MF-Ahmed/30-channel-remote-input-status-monitoring-system/(list of files, cad)

Other CAD files:
firmware/backup_29-03-2019/RIMS_4_BYTE_RECIEVER.X/dist/default/production/RIMS_4_BYTE_RECIEVER.X.production.obj
firmware/backup_29-03-2019/RIMS_4BYTE.X/dist/default/production/RIMS_4BYTE.X.production.obj
firmware/RIMS_4_BYTE_RECIEVER.X/dist/default/production/RIMS_4_BYTE_RECIEVER.X.production.obj
firmware/RIMS_4_BYTE_RECIEVER.X/l.obj
firmware/RIMS_4BYTE.X/l.obj
