MF-Ahmed/30-channel-remote-input-status-monitoring-system/Manual/flow chart01.pdf

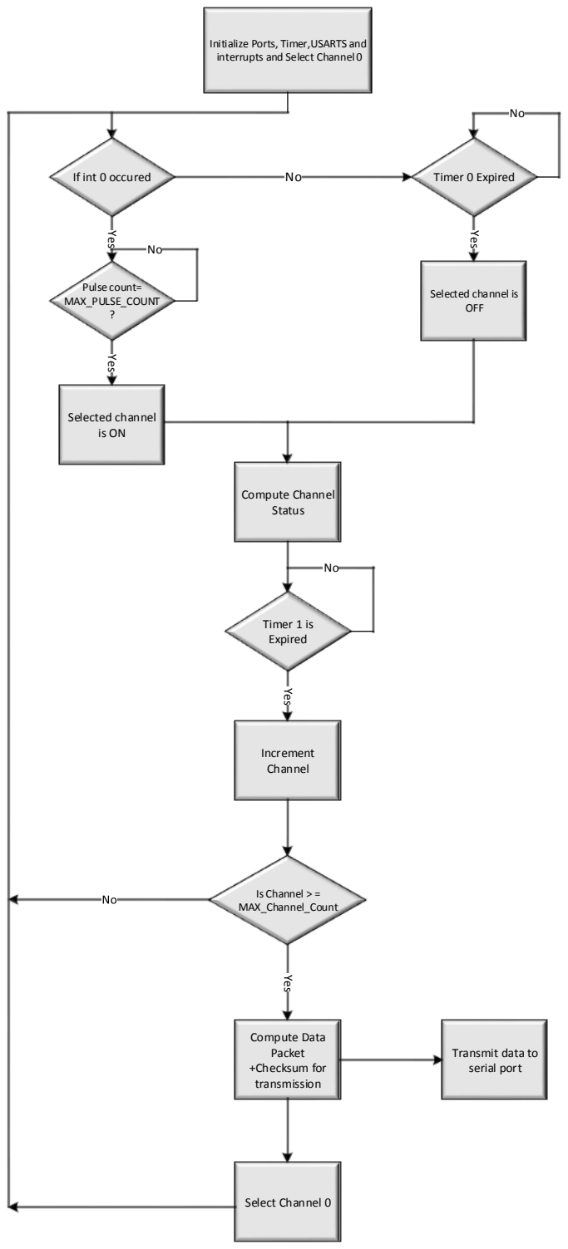
[picture p8: page 1]

If int 0 occured

Initialize Ports, Timer,USARTS and interrupts and Select Channel 0

Pulse count=
MAX_PULSE_COUNT
?

Selected channel
is ON

Timer 0 Expired

Selected channel is
OFF

Compute Channel
Status

Timer 1 is
Expired

Compute Data
Packet
+Checksum for
transmission

Is Channel > =
MAX_Channel_Count

Increment
Channel

Transmit data to
serial port

Select Channel 0

No

Yes

Yes

Yes Yes

Yes

No

No

No
