MF-Ahmed/30-channel-remote-input-status-monitoring-system/Manual/Master.png

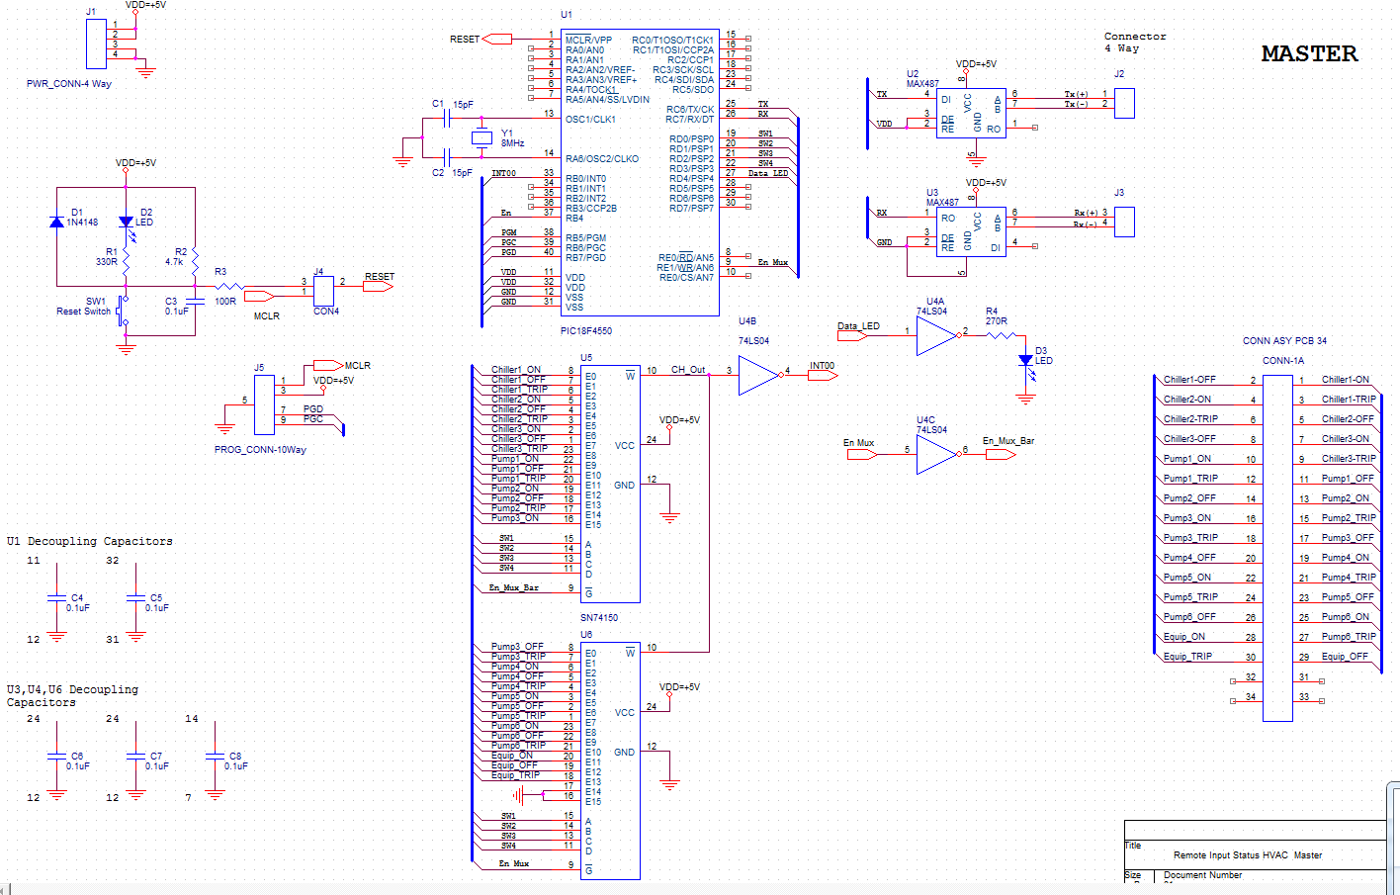
Manual/Master.png
