MF-Ahmed/30-channel-remote-input-status-monitoring-system/Manual/opto-1.png

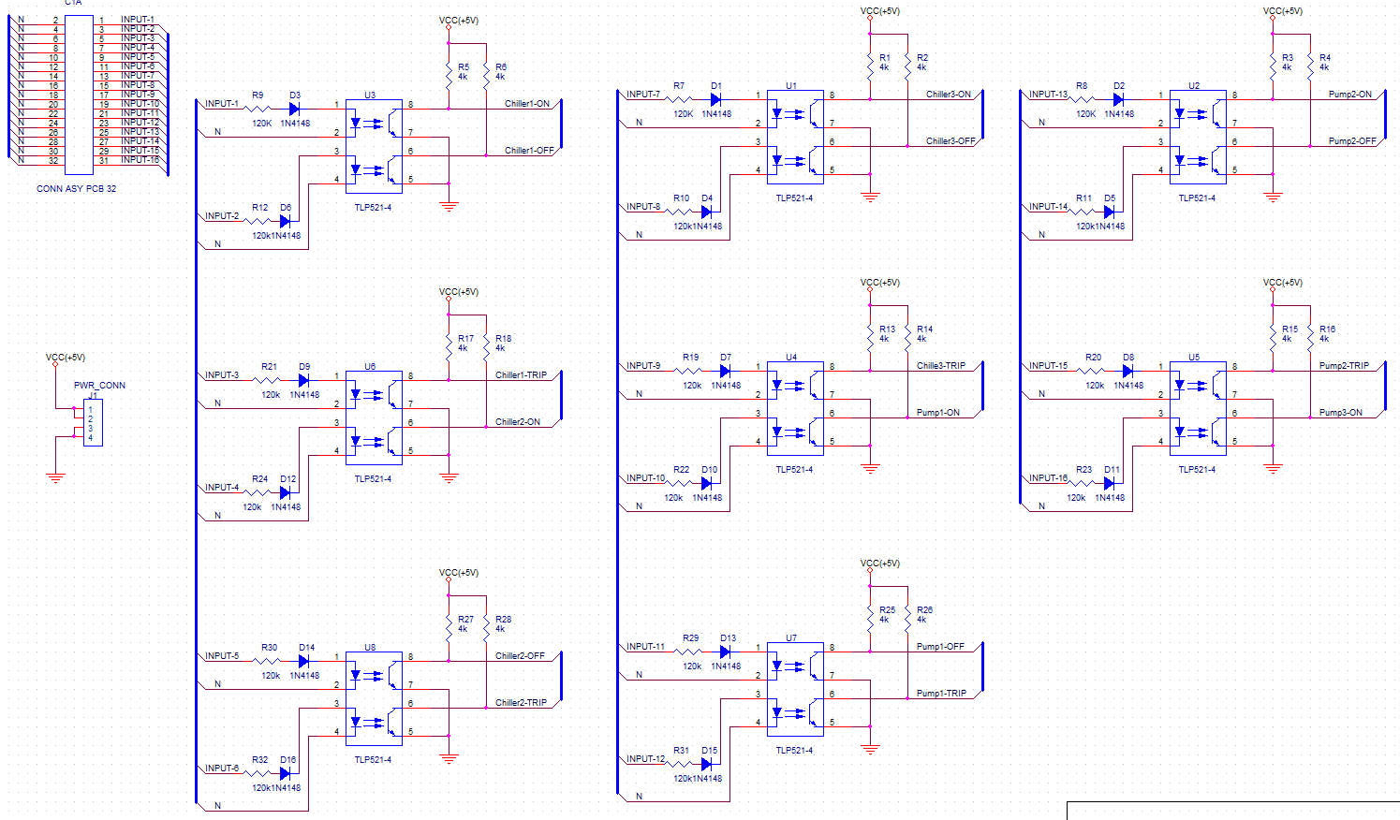
Manual/opto-1.png
