MF-Ahmed/30-channel-remote-input-status-monitoring-system/Manual/opto-2.png

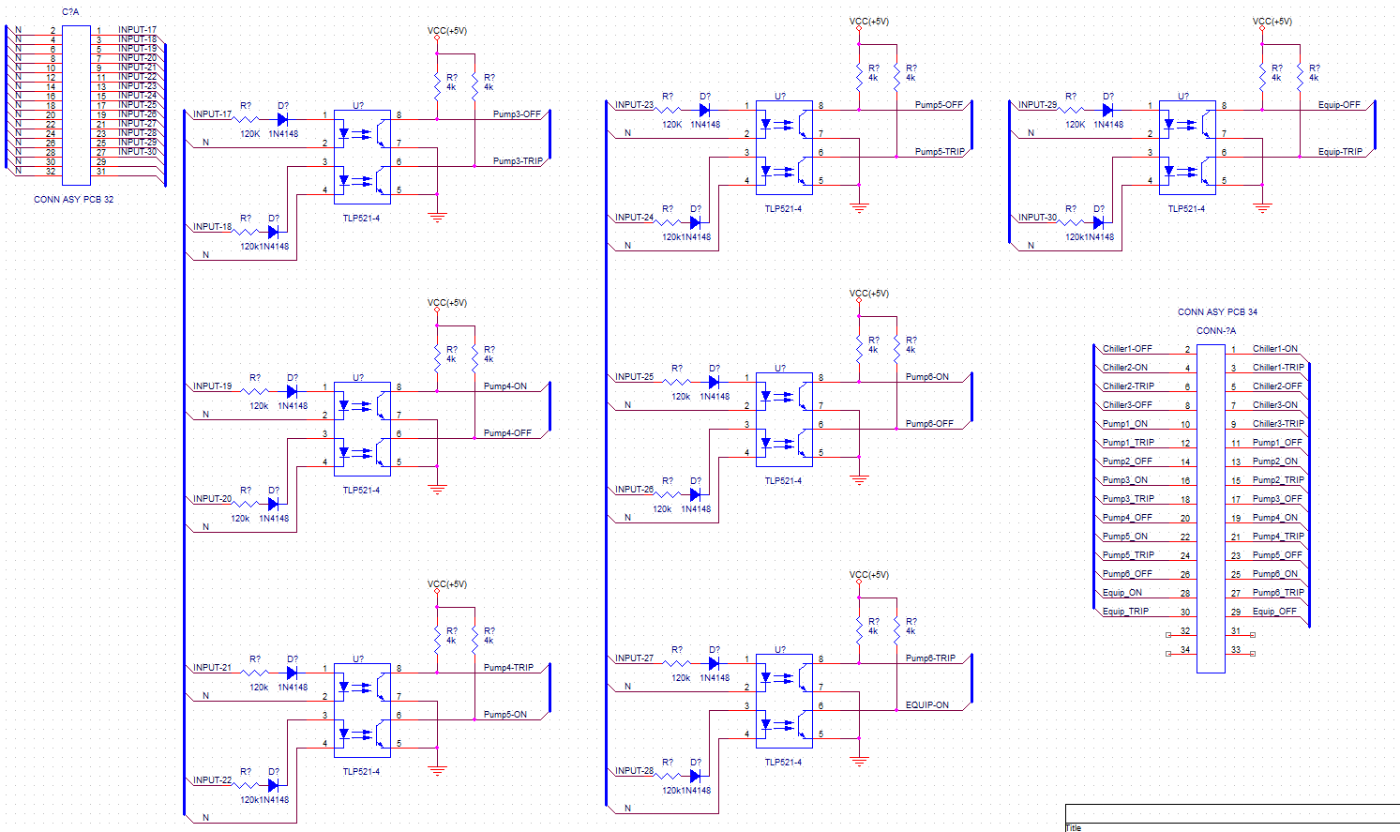
Manual/opto-2.png
