MF-Ahmed/30-channel-remote-input-status-monitoring-system/Manual/Slave-2.png

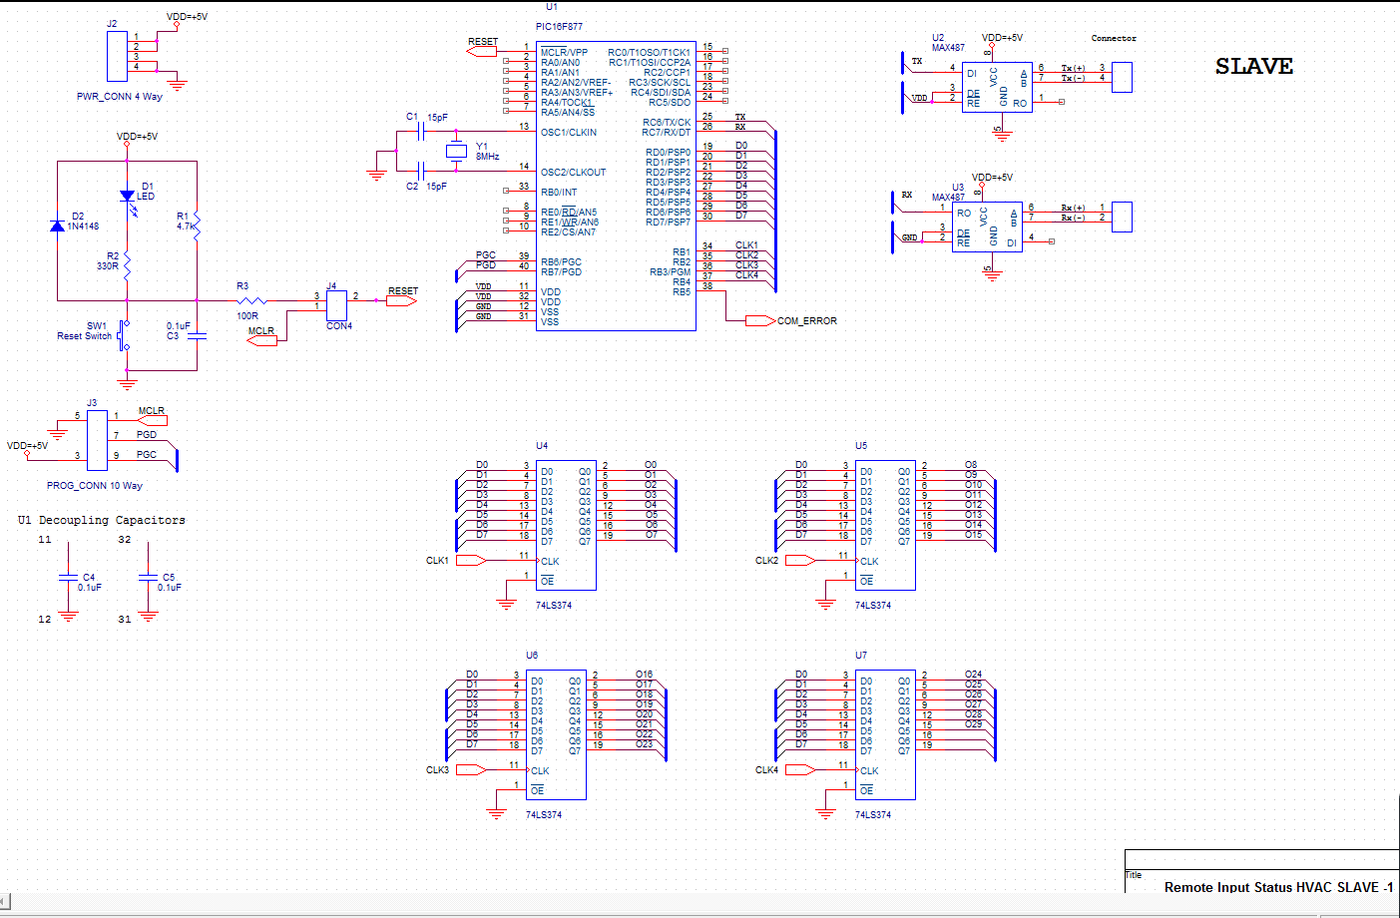
Manual/Slave-2.png
