MF-Ahmed/30-channel-remote-input-status-monitoring-system/(list of files, drawings)

Other design files:
Circuit/HVAC_CIRCUIT_Master_side/f1.opj
Circuit/HVAC_CIRCUIT_Master_side/f2.opj
Circuit/HVAC_CIRCUIT_Master_side/f3.opj
Circuit/HVAC_CIRCUIT_Master_side/f4.opj
Circuit/HVAC_CIRCUIT_Master_side/f14.opj
Circuit/HVAC_CIRCUIT_Master_side/hvac_design.dbk.dbk.dbk.dbk.opj
Circuit/HVAC_CIRCUIT_Master_side/HVAC_DESIGN.DBK.DBK.DBK.opj
Circuit/HVAC_CIRCUIT_Master_side/hvac_design.dbk.dbk.opj
Circuit/HVAC_CIRCUIT_Master_side/hvac_design.dbk.opj
Circuit/HVAC_CIRCUIT_Master_side/HVAC_DESIGN.DSN
Circuit/HVAC_CIRCUIT_Master_side/HVAC_DESIGN.opj
Circuit/HVAC_CIRCUIT_Slave_side/f1.opj
Circuit/HVAC_CIRCUIT_Slave_side/f2.opj
Circuit/HVAC_CIRCUIT_Slave_side/slave side.dbk.dbk.dbk.dbk.dbk.dbk.opj
Circuit/HVAC_CIRCUIT_Slave_side/slave side.dbk.dbk.dbk.dbk.dbk.opj
Circuit/HVAC_CIRCUIT_Slave_side/slave side.dbk.dbk.dbk.dbk.opj
Circuit/HVAC_CIRCUIT_Slave_side/SLAVE SIDE.DBK.DBK.DBK.opj
Circuit/HVAC_CIRCUIT_Slave_side/slave side.dbk.dbk.opj
Circuit/HVAC_CIRCUIT_Slave_side/slave side.dbk.opj
Circuit/HVAC_CIRCUIT_Slave_side/SLAVE SIDE.DSN
Circuit/HVAC_CIRCUIT_Slave_side/slave side.opj
Circuit/OptoSide/f1.opj
Circuit/OptoSide/f2.opj
Circuit/OptoSide/f8.opj
Circuit/OptoSide/REMOTE INPUT STATUS MONITORING SYSTEM.DSN
Circuit/OptoSide/Remote Input Status Monitoring System.opj
RELATED DOCS/SIMULATION/30_channel_experiment_uart_single_transmission.pdsprj
